Radeon91/Draw-Machine/STL archivos 3d/Y_Back.STL

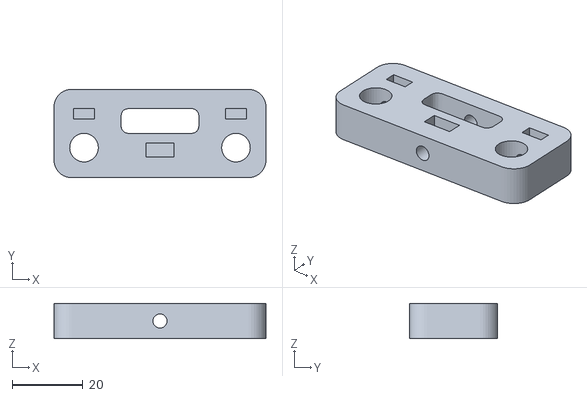
[picture p33: CAD file, 2020-03-24]
STL archivos 3d/Y_Back.STL
60.0 x 25.0 x 10.0
