Radeon91/Draw-Machine/STL archivos 3d/X_support_R.stl

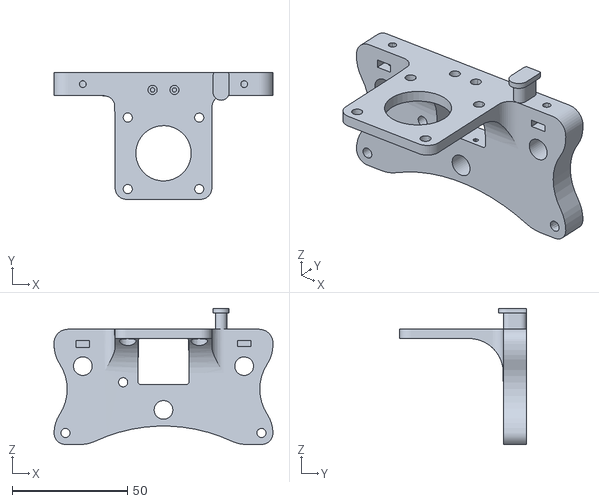
[picture p34: CAD file, 2020-03-24]
STL archivos 3d/X_support_R.stl
95.0 x 55.0 x 59.0
