Radeon91/Draw-Machine/STL archivos 3d/X_support_L.STL

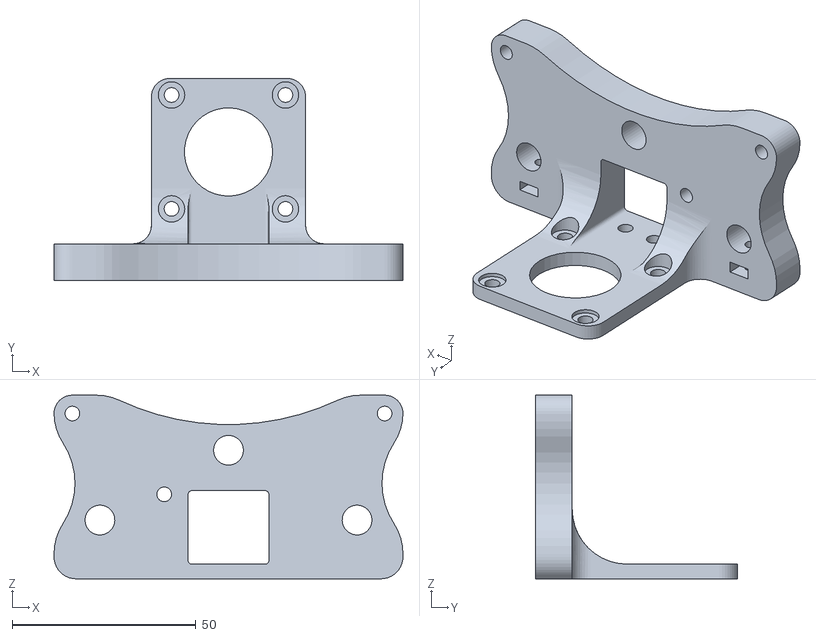
[picture p35: CAD file, 2020-03-24]
STL archivos 3d/X_support_L.STL
95.0 x 55.0 x 50.0
