Radeon91/Draw-Machine/STL archivos 3d/Pen_Holder.stl

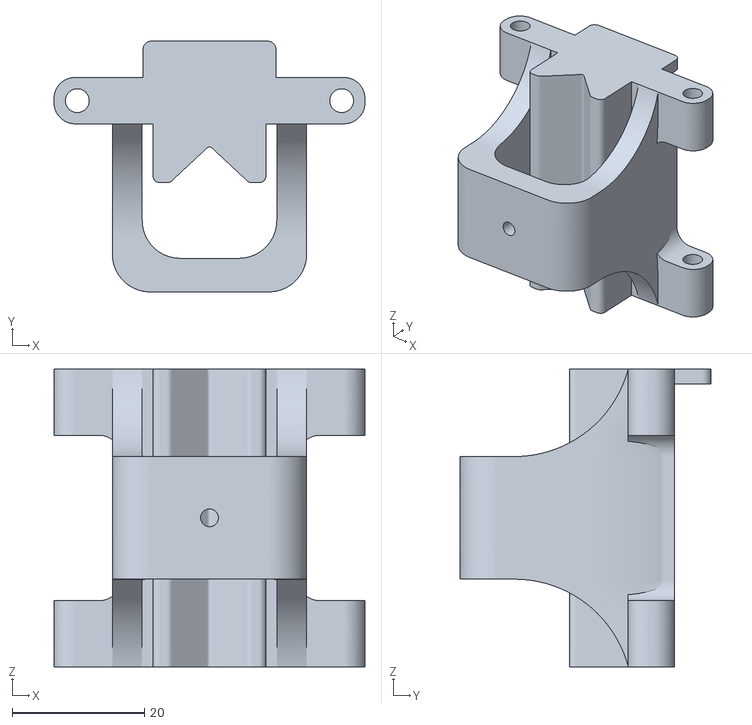
[picture p36: CAD file, 2020-03-24]
STL archivos 3d/Pen_Holder.stl
47.0 x 37.9 x 45.0
