Radeon91/Draw-Machine/STL archivos 3d/Uno_CNC_Top.stl

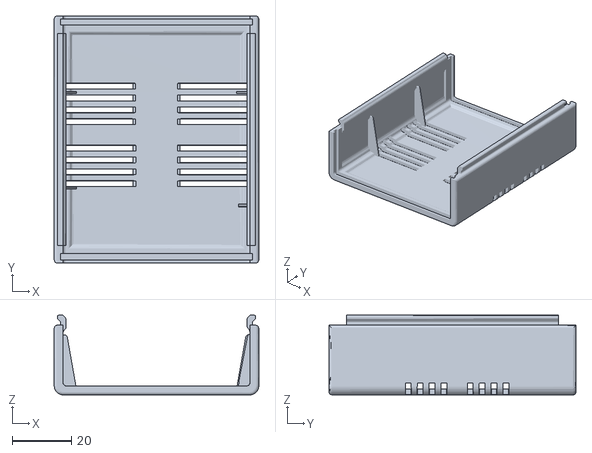
[picture p38: CAD file, 2020-03-24]
STL archivos 3d/Uno_CNC_Top.stl
69.0 x 83.3 x 26.9
