Radeon91/Draw-Machine/STL archivos 3d/Bottom_XY_clamshell_V2.stl

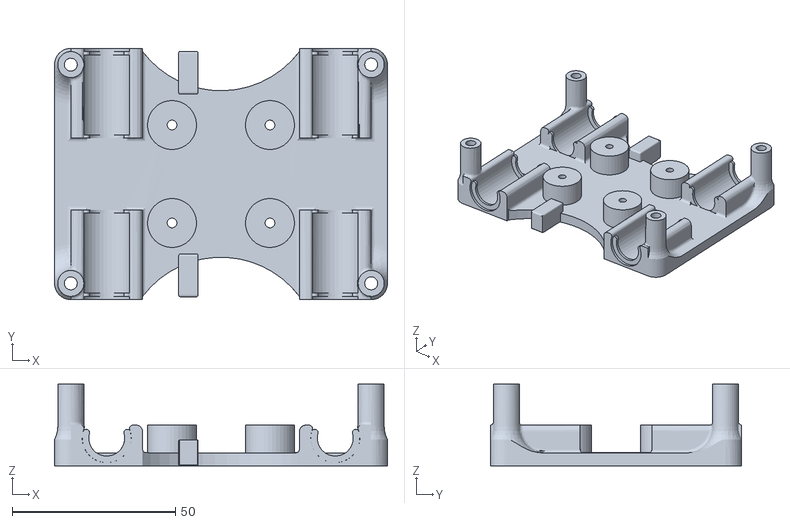
[picture p39: CAD file, 2020-03-24]
STL archivos 3d/Bottom_XY_clamshell_V2.stl
102.0 x 77.0 x 25.0
