Radeon91/Draw-Machine/STL archivos 3d/Uno_CNC_Back.stl

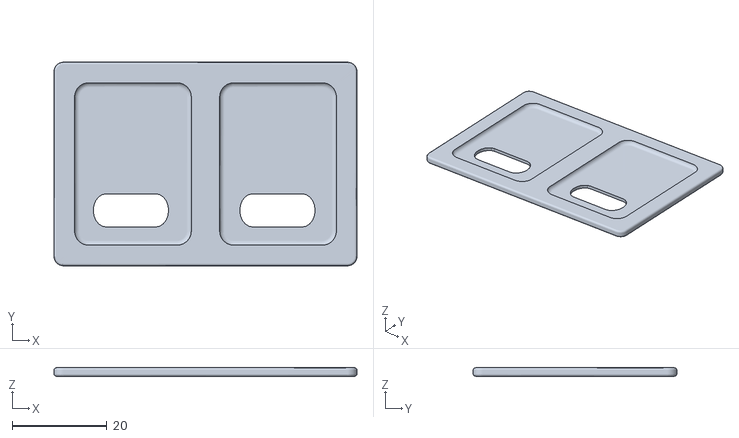
[picture p40: CAD file, 2020-03-24]
STL archivos 3d/Uno_CNC_Back.stl
64.0 x 43.0 x 1.80
