Radeon91/Draw-Machine/STL archivos 3d/Base_Slide_Heavy_Duty_V4.stl

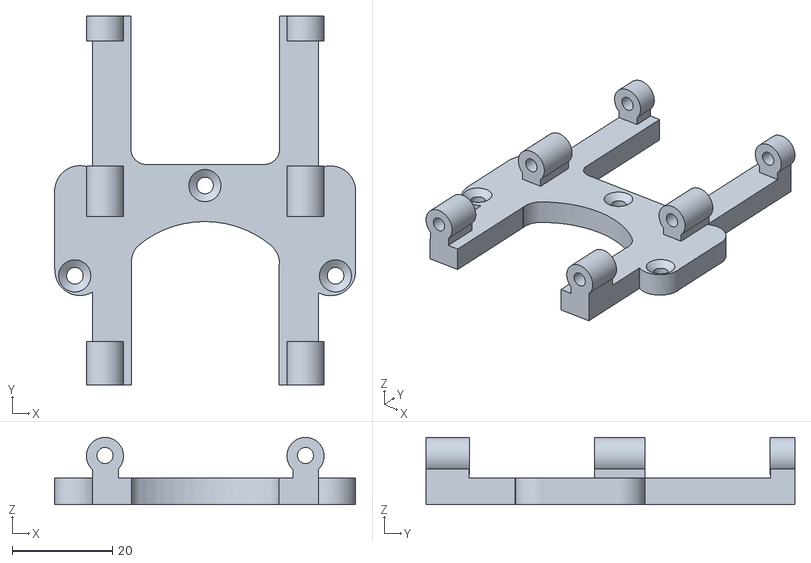
[picture p41: CAD file, 2020-03-24]
STL archivos 3d/Base_Slide_Heavy_Duty_V4.stl
60.1 x 73.6 x 13.4
