Radeon91/Draw-Machine/STL archivos 3d/Slider_Heavy_Duty_V5.stl

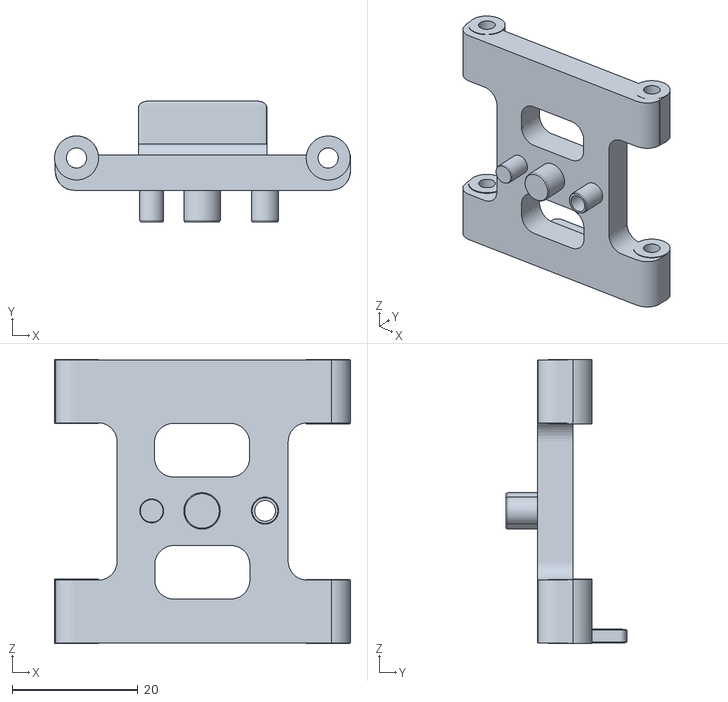
[picture p42: CAD file, 2020-03-24]
STL archivos 3d/Slider_Heavy_Duty_V5.stl
47.0 x 19.2 x 45.2
