Radeon91/Draw-Machine/STL archivos 3d/Uno_CNC_Bottom.stl

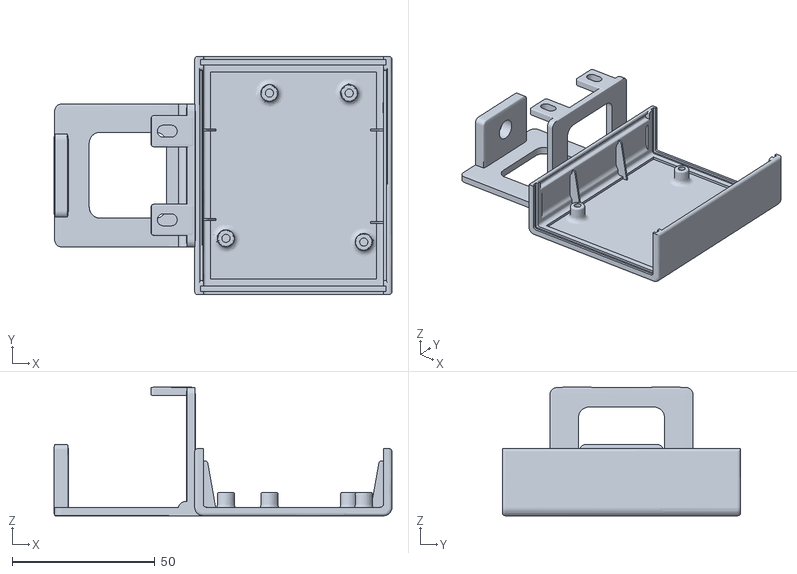
[picture p43: CAD file, 2020-03-24]
STL archivos 3d/Uno_CNC_Bottom.stl
118.2 x 83.3 x 45.0
