Radeon91/Draw-Machine/STL archivos 3d/idler_18x13x6_01.stl

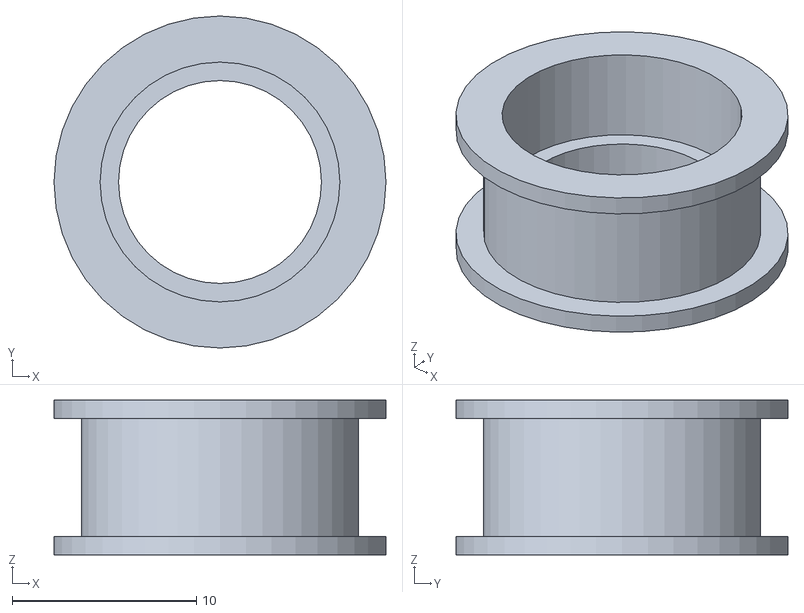
[picture p44: CAD file, 2020-03-24]
STL archivos 3d/idler_18x13x6_01.stl
18.0 x 18.0 x 8.40
