Radeon91/Draw-Machine/STL archivos 3d/spacer_8x4x3-5.stl

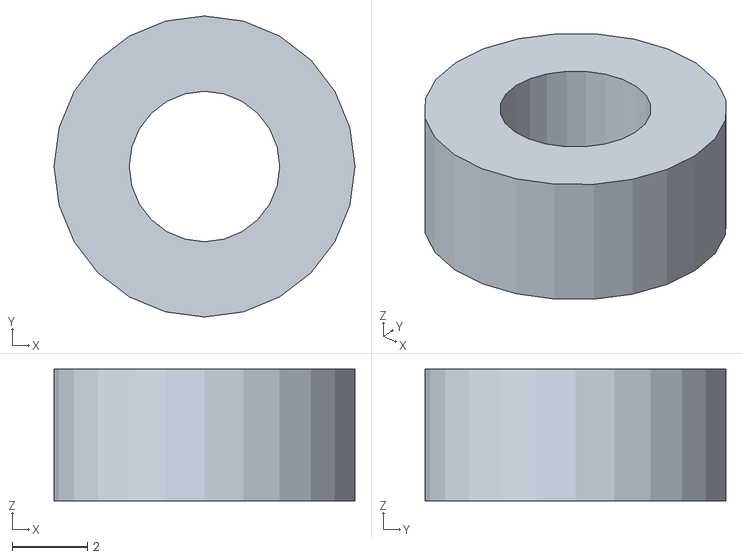
[picture p45: CAD file, 2020-03-24]
STL archivos 3d/spacer_8x4x3-5.stl
8.00 x 8.00 x 3.50
