Radeon91/Draw-Machine/STL archivos 3d/Top_XY_clamshell_V4.stl

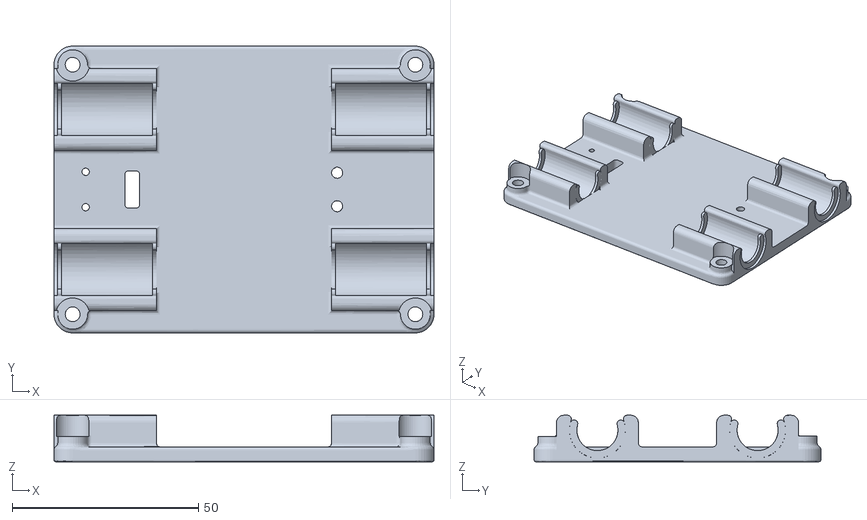
[picture p46: CAD file, 2020-03-24]
STL archivos 3d/Top_XY_clamshell_V4.stl
102.0 x 77.0 x 12.5
