Radeon91/Draw-Machine/STL archivos 3d/Y_Front.stl

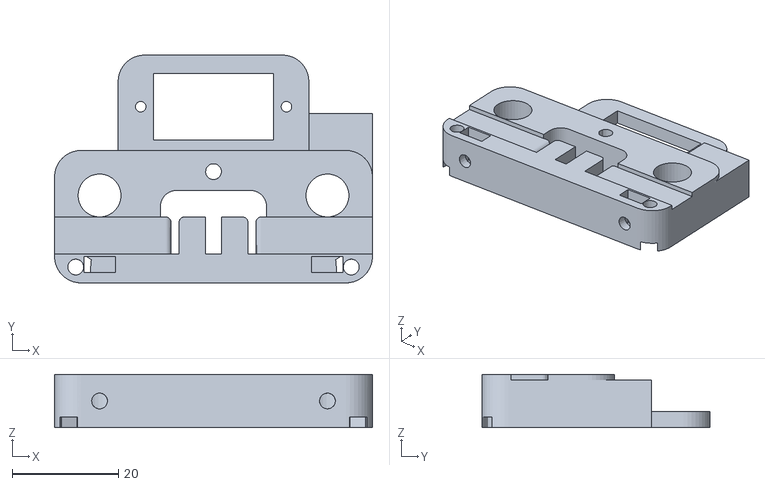
[picture p47: CAD file, 2020-03-24]
STL archivos 3d/Y_Front.stl
60.0 x 43.0 x 10.0
